avmm9898/Robot_final_Pj/doc/期末專題車體簡介 .pptx.pdf

# 機器人動力與控制 期末專題

# outline

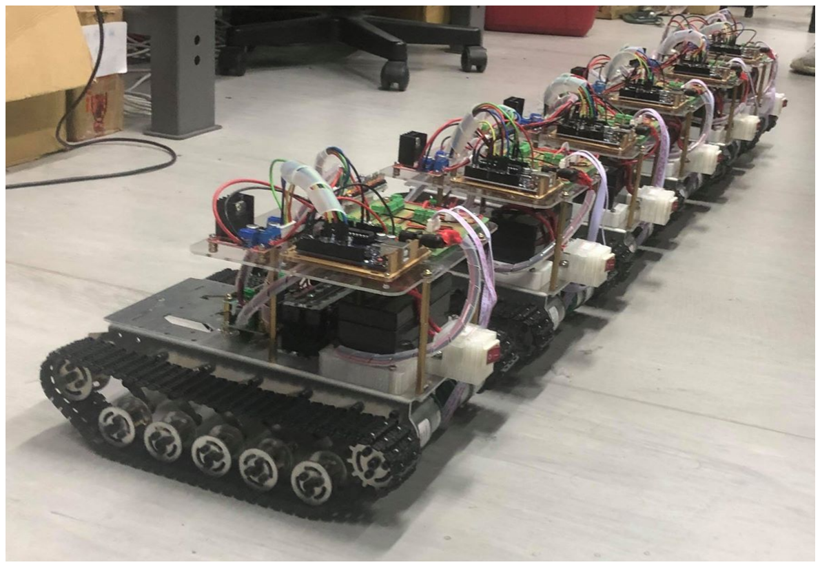
[picture p38: figure]

## 1. 期末專題任務介紹 2. 車體機構及硬體配置

### 3. 控制器 (arduino & pca9685) 4. 馬達驅動器 (h-bridge) 5. 馬達及Encoder

## 6. 線路圖及電路板 7. 機械手臂 8. 視覺辨識

### 9. arduino與pc的溝通 10. demo

## 11. 充電注意事項

# 期末專題任務介紹

在這次的專題中，我們的目標是讓履帶車前進，並控制車上的4R手臂，使其末端插入目標物的洞裡。

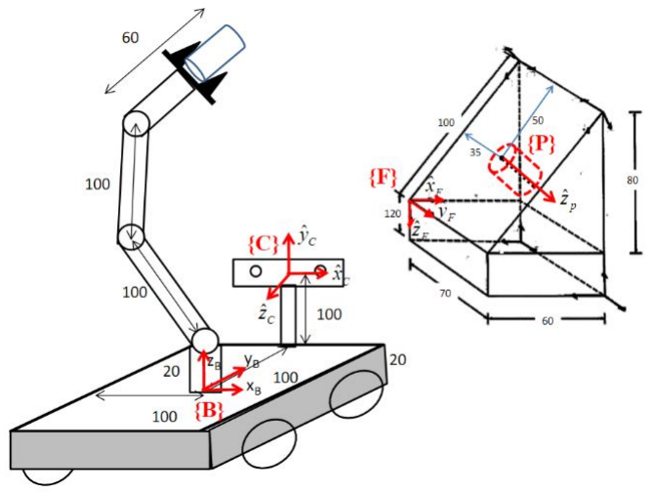
[picture p39: figure]

流程:
車體擺放在場地任一位置(可看到目標物)

車子移動到目標物旁

手臂移動使物件依序插入三個洞口(大中小)

# 車體機構及硬體配置

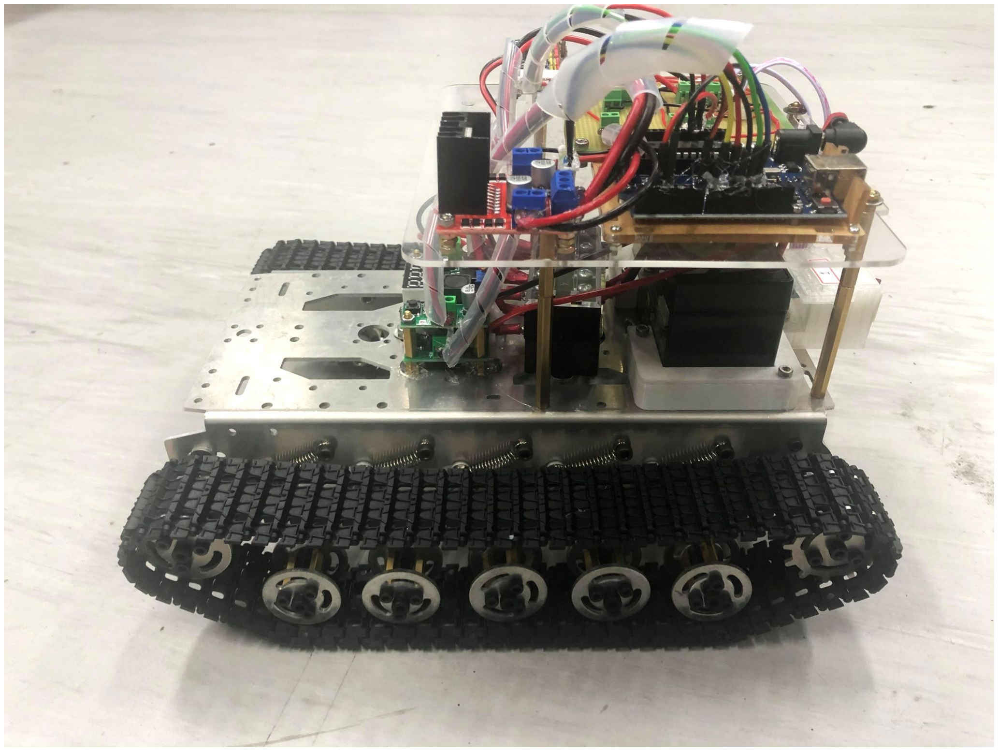
[picture p40: figure]

2nd floor:
Arduino、pca9685、H-bridge、電路板

1st floor:
開關、電池、端子台x2、降壓模組x2

# 分層介紹

# 控制器 (arduino & pca9685)

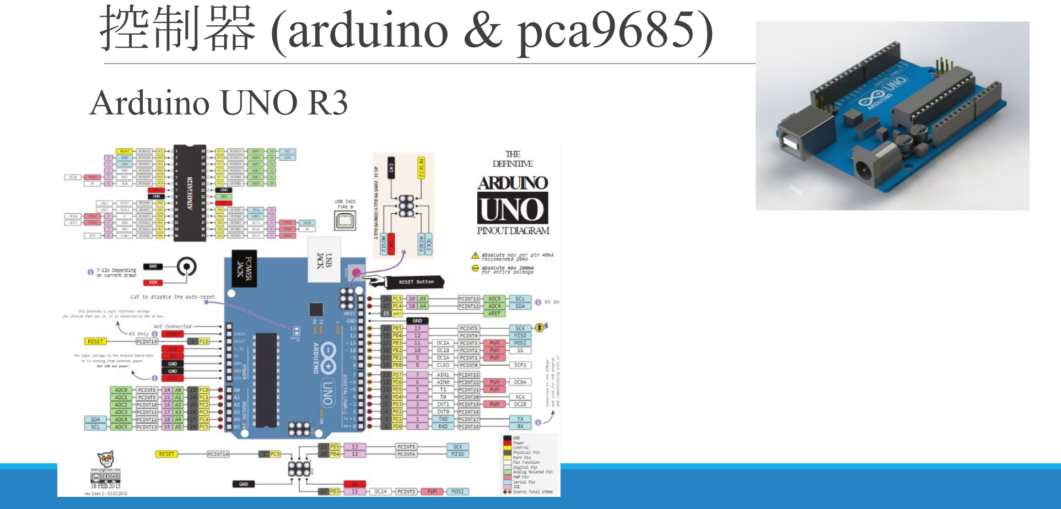
[picture p41: page 5]

## Arduino UNO R3

# Arduino 腳位分配

pin13 : h-bridge IN1 | pin6~ : 未使用
pin12: h-bridge IN2 | pin5~ : 未使用
pin11~ : h-bridge ENA | pin4 : 未使用

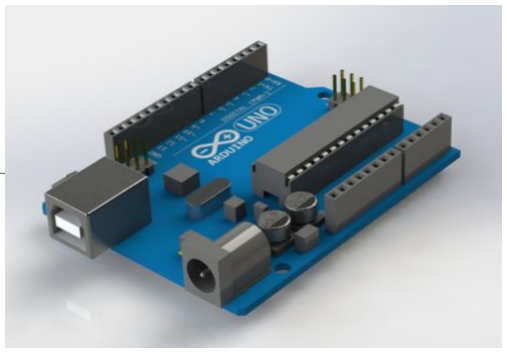
[picture p42: figure]

pin10~ : h-bridge ENB | pin3~ : 馬達B之encoder B相 | A4 : pca9685的SCA
pin9~ : 未使用 | pin2 : 馬達A之encoder B相 | A5 :pca9685的SCL

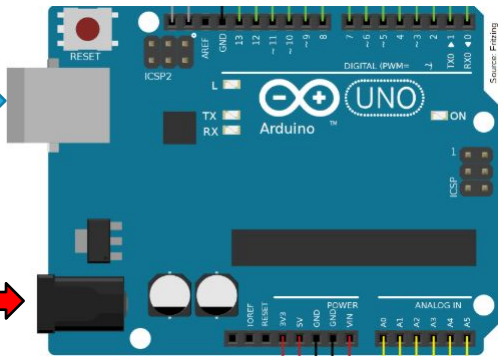
[picture p43: figure]

pin8 : h-bridge IN3

pin7 : h-bridge IN4

Vin (12V)

computer

# pca9685

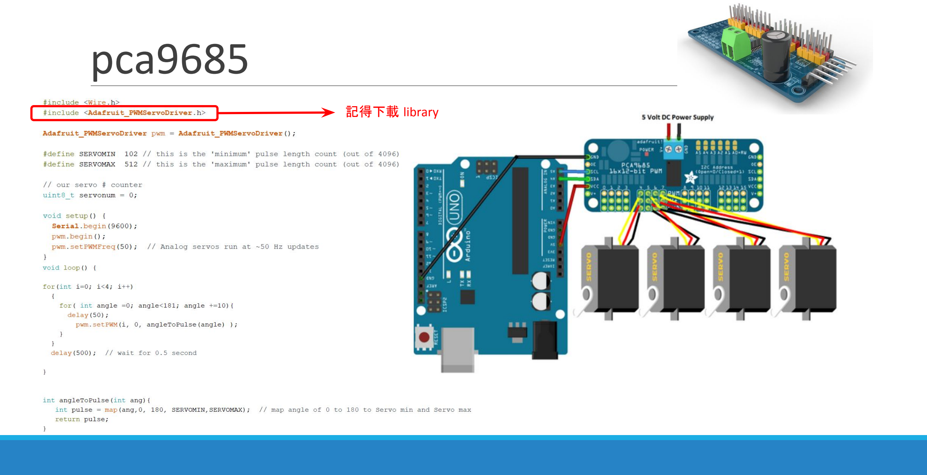
[picture p44: page 7]

記得下載 library

# 馬達驅動器 (H-bridge)

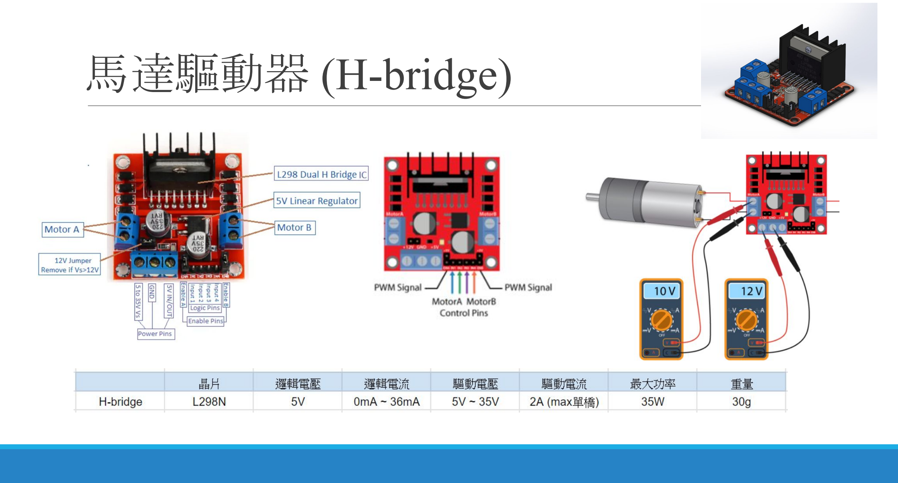
[picture p45: page 8]

# H-bridge 基礎控制 (直走)

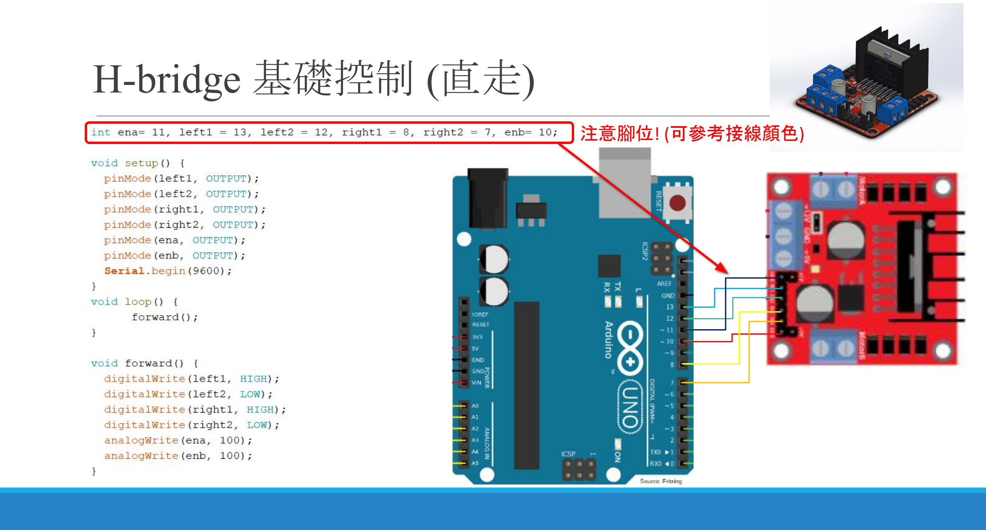
[picture p46: page 9]

注意腳位! (可參考接線顏色)

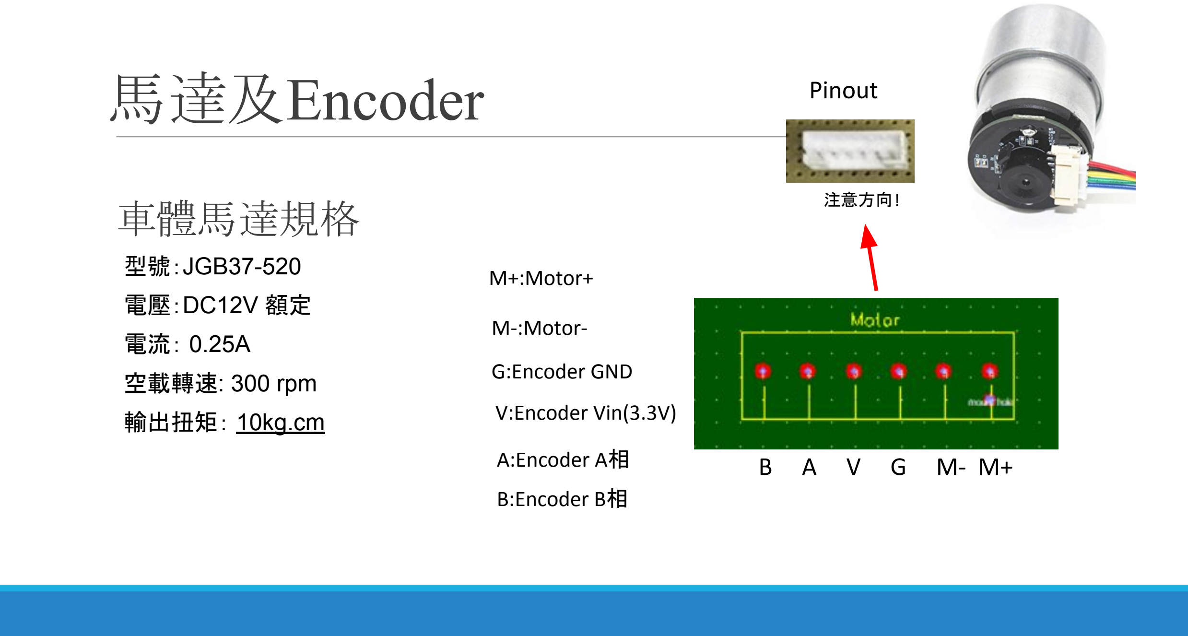
[picture p47: figure]
馬達及Encoder; 型號：JGB37-520; 空載轉速: 300 rpm; 輸出扭矩： 10kg.cm; M+:Motor+; M-:Motor-; G:Encoder GND; V:Encoder Vin(3.3V); A:Encoder A相; B:Encoder B相; 注意方向!; Pinout; 車體馬達規格

# Encoder

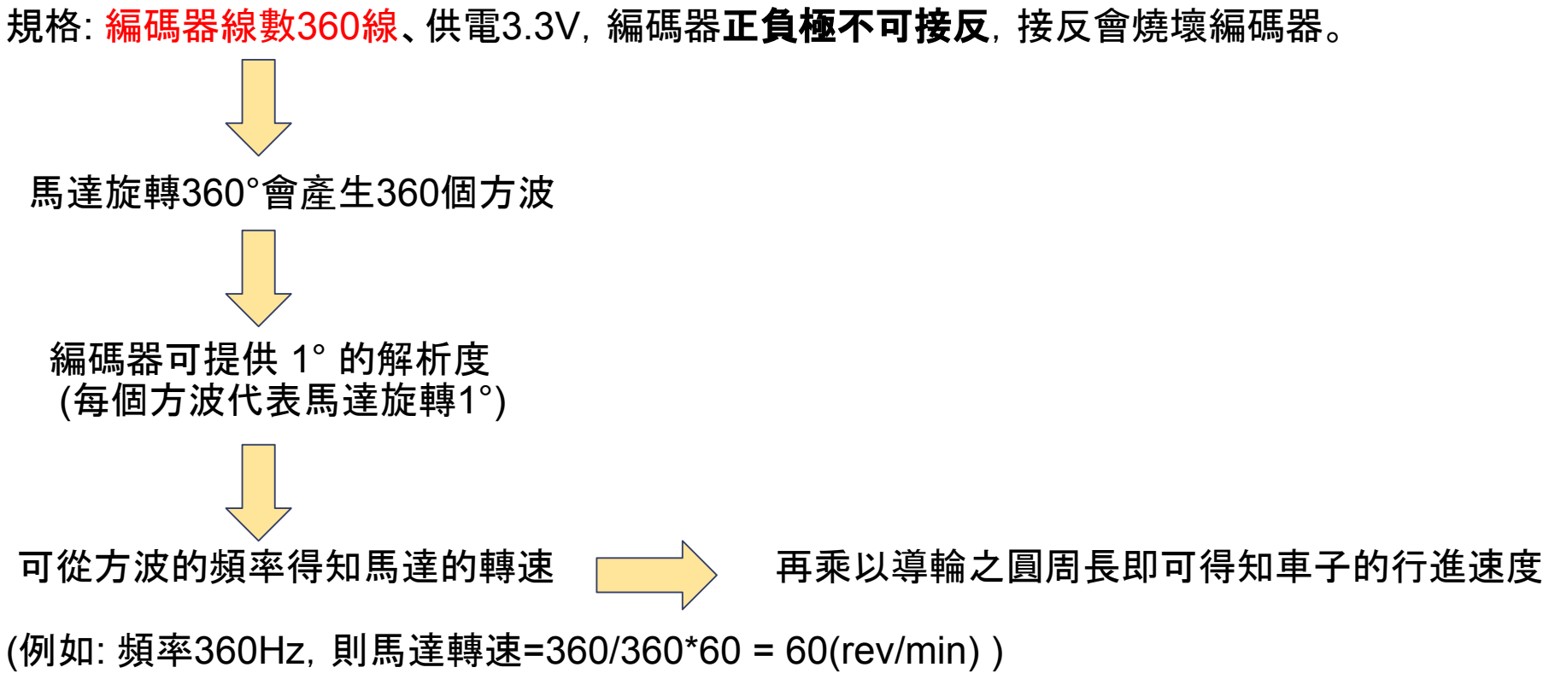
[picture p48: figure]
規格: 編碼器線數360線、供電3.3V，編碼器正負極不可接反，接反會燒壞編碼器。; 馬達旋轉360°會產生360個方波; 編碼器可提供 1° 的解析度; (每個方波代表馬達旋轉1°); 可從方波的頻率得知馬達的轉速; 再乘以導輪之圓周長即可得知車子的行進速度; (例如: 頻率360Hz，則馬達轉速=360/360*60 = 60(rev/min) )

# encoder AB相

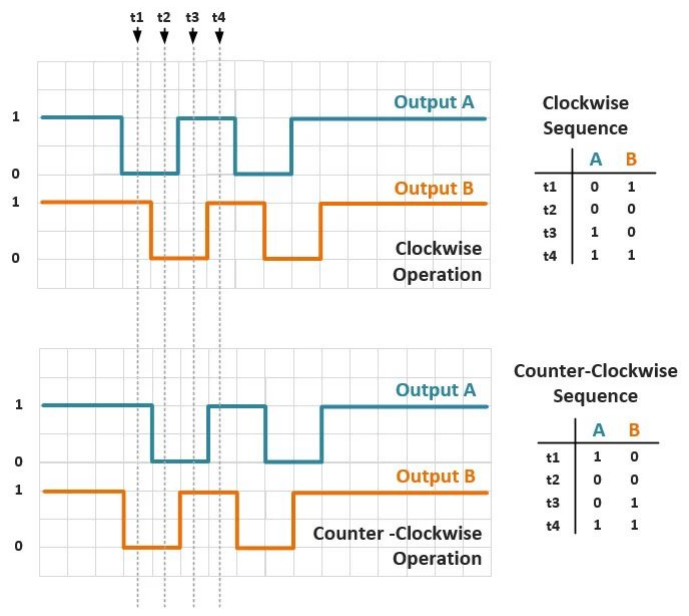
[picture p49: figure]

encoder 輸出的訊號分成A、B相，兩者之相位差為90°

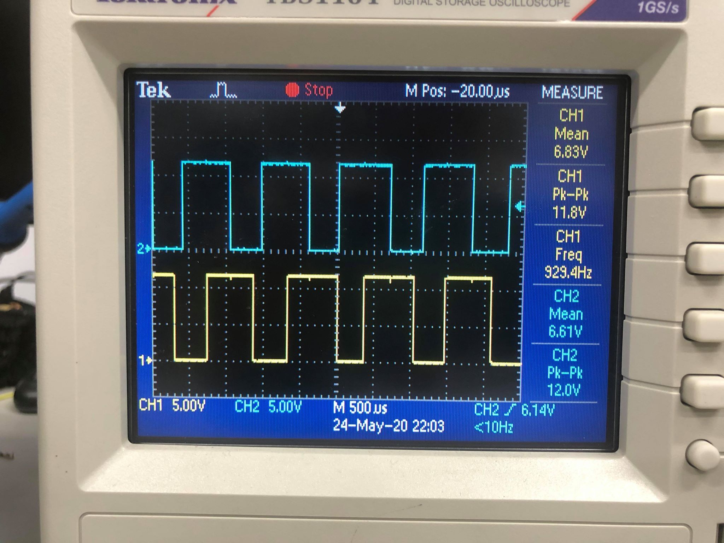
[picture p50: figure]

可從A、B相之先後關係得知馬達的轉向 | 實際測試訊號:

# encoder AB相

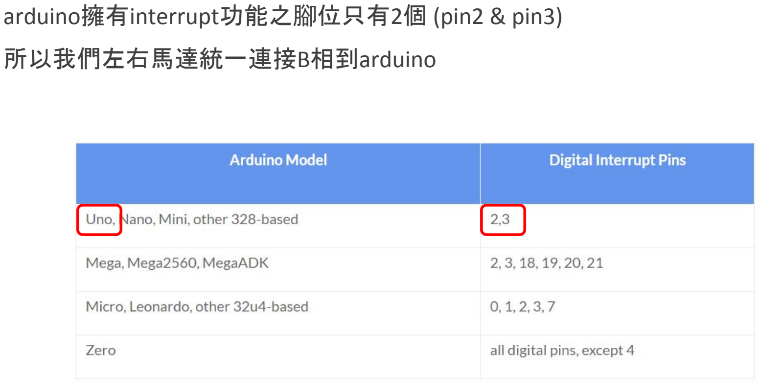
[picture p51: figure]
arduino擁有interrupt功能之腳位只有2個 (pin2 & pin3); 所以我們左右馬達統一連接B相到arduino

# encoder量測馬達轉速 範例程式

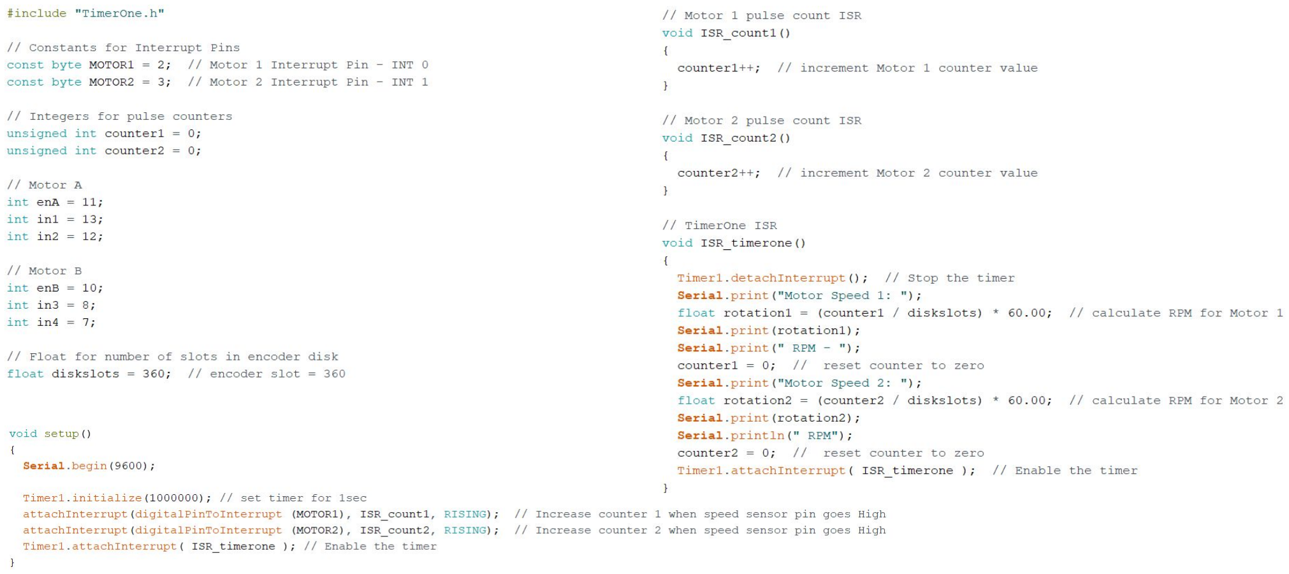
[picture p52: figure]

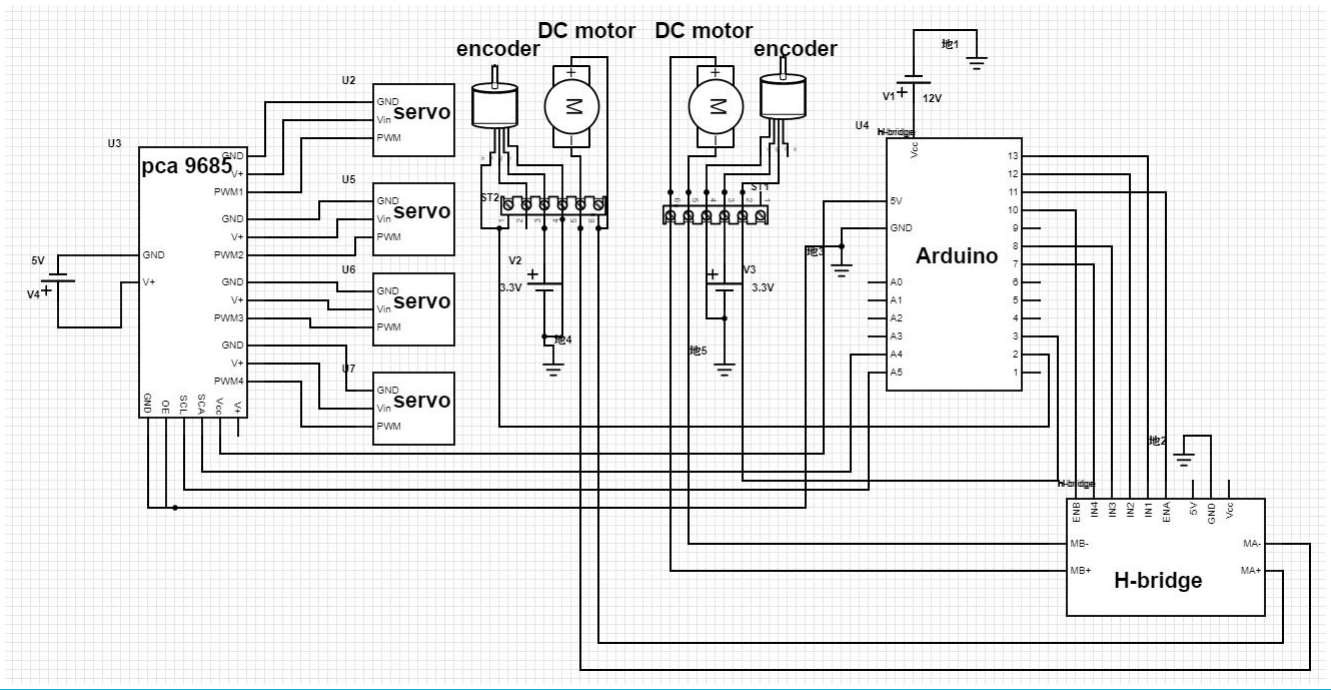
[picture p53: figure]

# 線路圖

# 線路圖及電路板

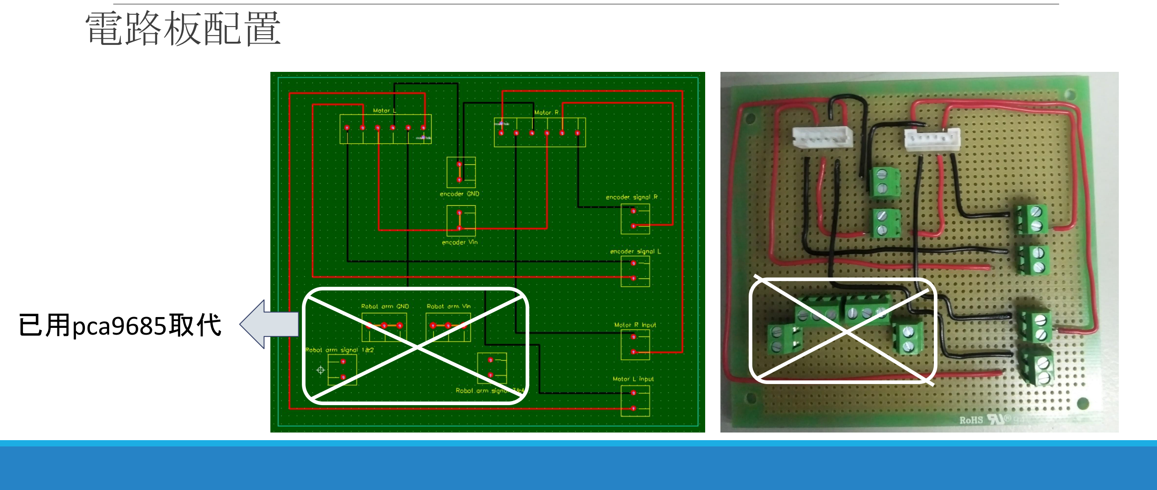
[picture p54: page 16]

# 電路板配置

### 已用pca9685取代

# 機械手臂

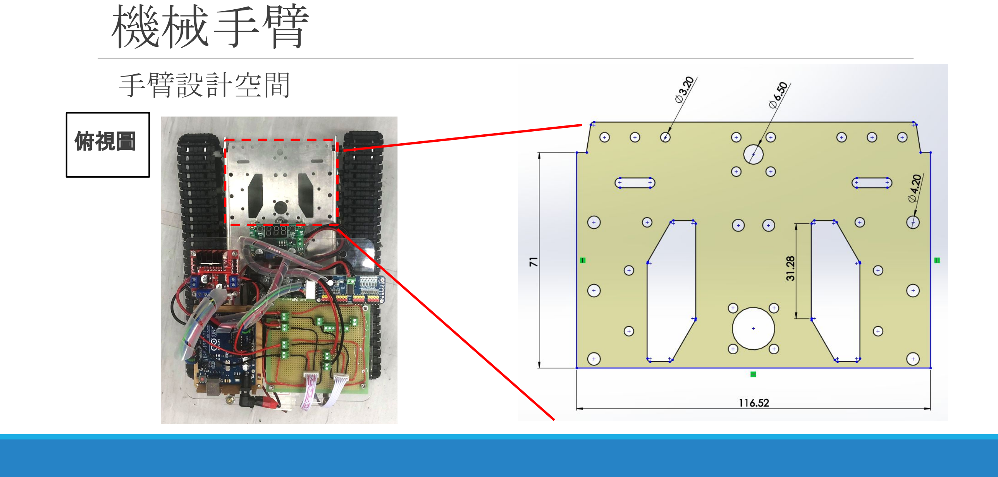
[picture p55: page 17]

俯視圖

## 手臂設計空間

# MG996R 規格

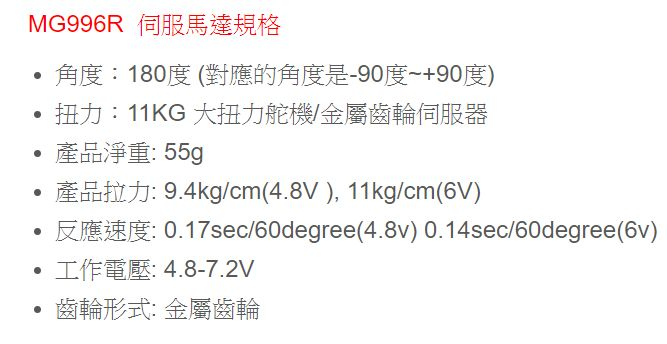
[picture p56: figure]

# MG996R solidworks

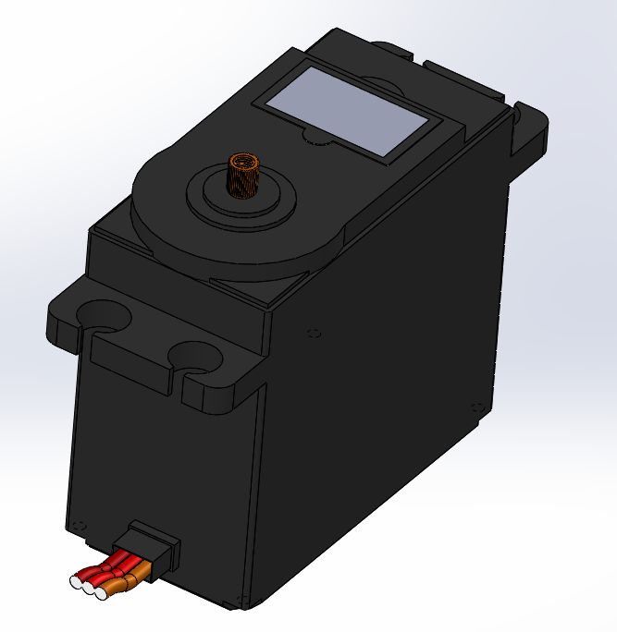
[picture p57: figure]
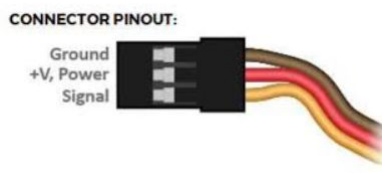
[picture p58: figure]

# 視覺辨識

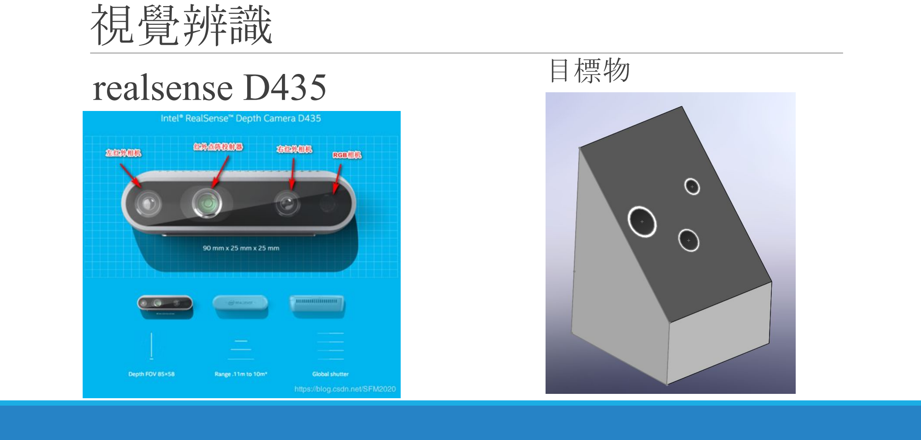
[picture p59: page 20]

realsense D435 | 目標物

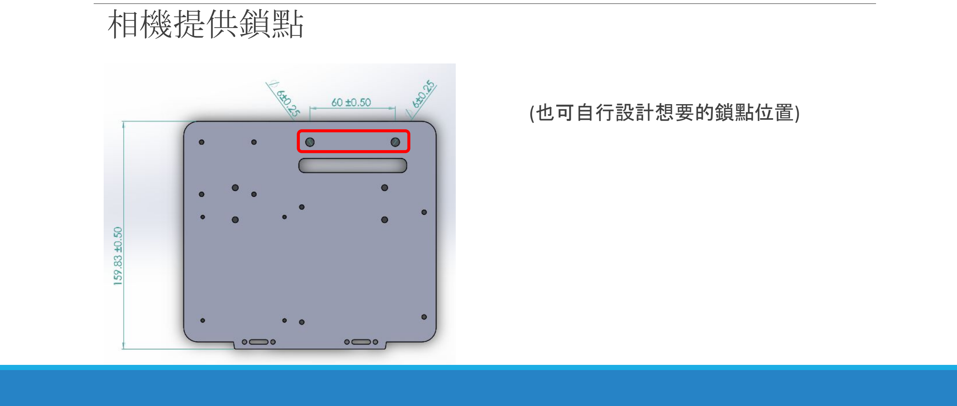
[picture p60: figure]
相機提供鎖點; (也可自行設計想要的鎖點位置)

# arduino與pc的溝通

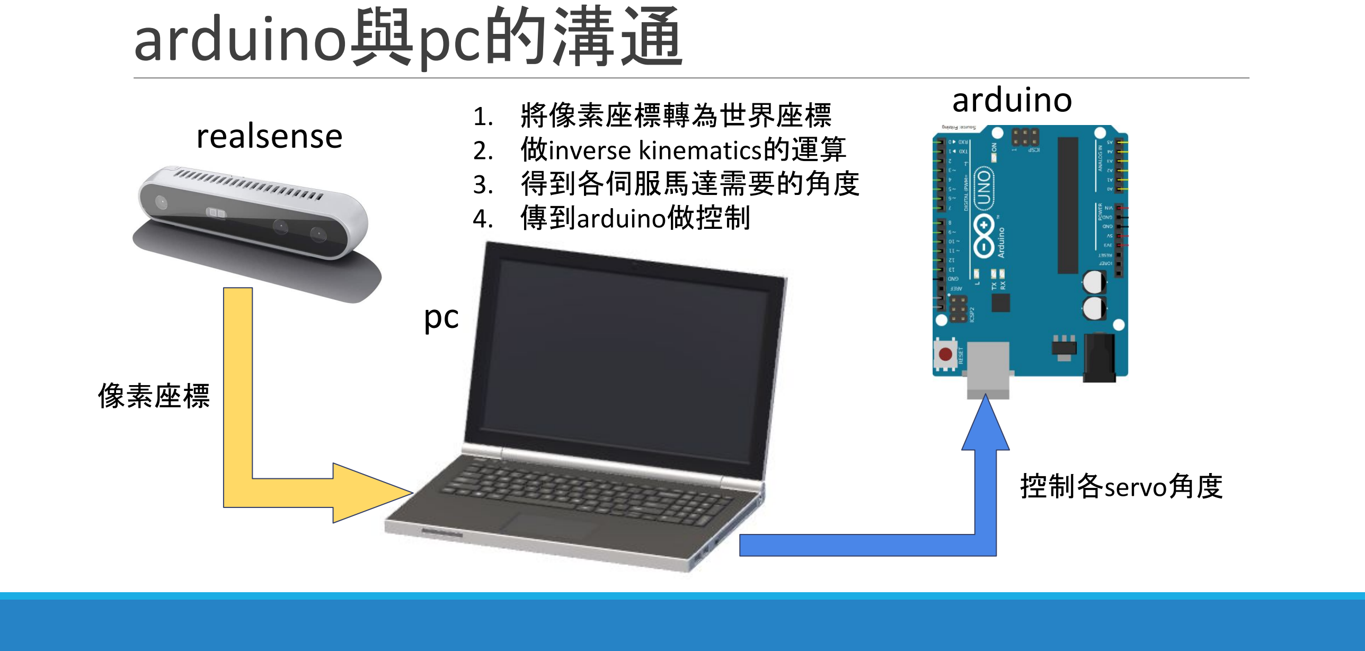
[picture p61: page 22]

## arduino

pc

realsense | 1. 將像素座標轉為世界座標
2. 做inverse kinematics的運算
3. 得到各伺服馬達需要的角度
4. 傳到arduino做控制

像素座標

控制各servo角度

# arduino與pc的溝通 範例程式

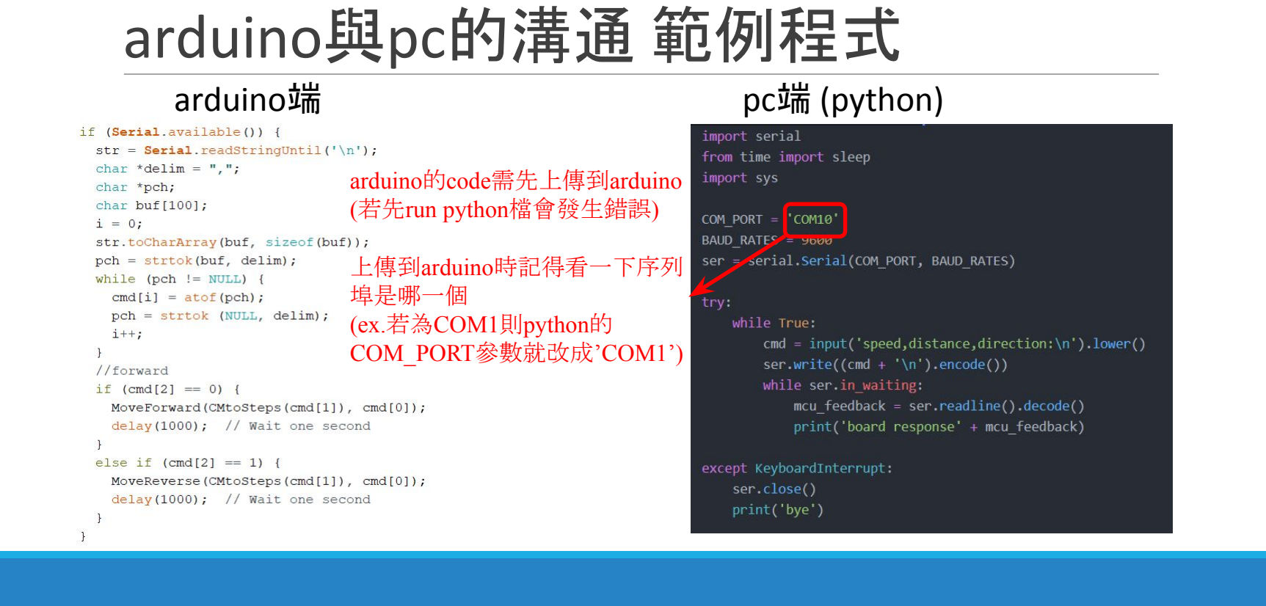
[picture p62: page 23]

arduino端 | pc端 (python)

arduino的code需先上傳到arduino
(若先run python檔會發生錯誤)

上傳到arduino時記得看一下序列
埠是哪一個
(ex.若為COM1則python的
COM_PORT參數就改成’COM1’)

# Demo

https://drive.google.com/file/d/1jVOSERYCBmgXQUd8nwmonmRnAgIjn4SV/view?usp=sharing (https://drive.google.com/file/d/1jVOSERYCBmgXQUd8nwmonmRnAgIjn4SV/view?usp=sharing)

# 充電注意事項

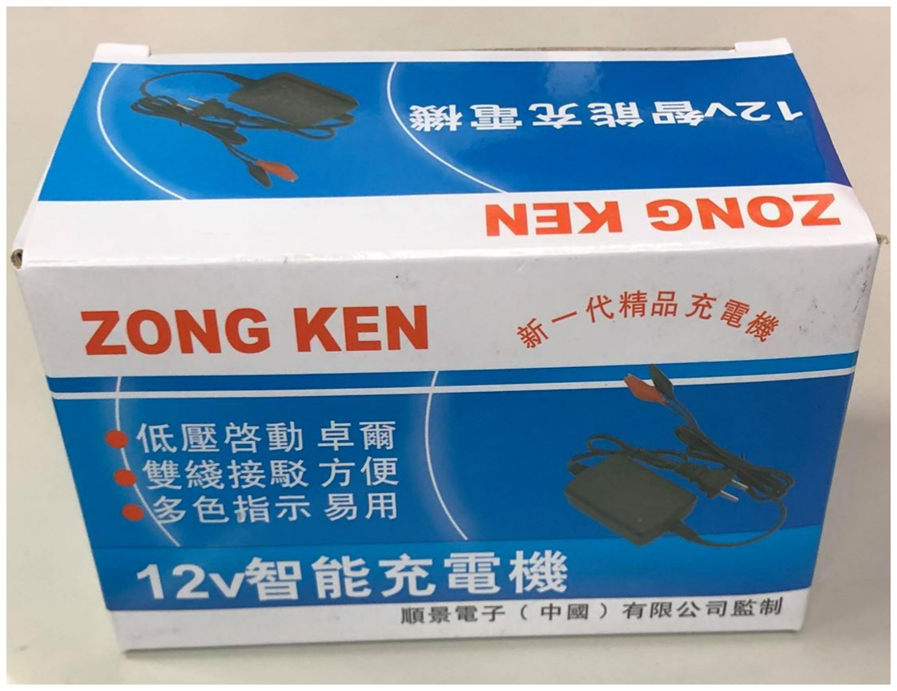
[picture p63: figure]

### 週五 (5/29) 之後在知武館原創 (200) 會放充電器

- 正接正 負接負
- 充電時把連接電池的線都拔掉
- 充電時會亮紅燈 充滿亮綠燈
- 大概半小時內就會充滿 (不要充太久 電池會壞)
