avmm9898/Robot_final_Pj/doc/431110_Real time circle detection using Realsense D435i.pptx

## Real time circle detection using Realsense D435i

2020/05/29
劉柏誼

## Outline

- 環境設置
- Realsense 使用方法
- 找圓與圓心演算法
- 座標系轉換

## 環境配置

- Anaconda 環境安裝
  - 安裝網址 : https (https://www.anaconda.com/)://www.anaconda.com/ (https://www.anaconda.com/)
  - OS : Windows、Linux、Mac
- Anaconda 介紹
  - Python數據科學平台
  - 套件管理
  - 虛擬環境管理

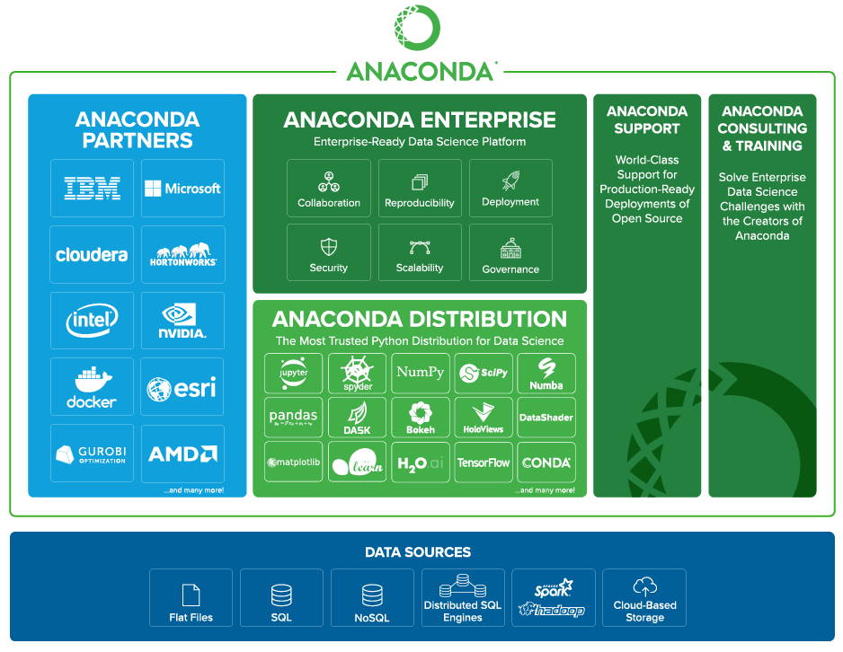
[picture p64: figure]

Ref: https://reurl.cc/d0OyMg

## 環境配置

- 使用搜尋開啟Anaconda Prompt
- 輸入’’conda create -n robot_final python==3.6’’ 創立名為’’robot_final’’的虛擬環境
  - (-n後名子可任設，python版本一個人喜好使用)
- 設置成功後畫面

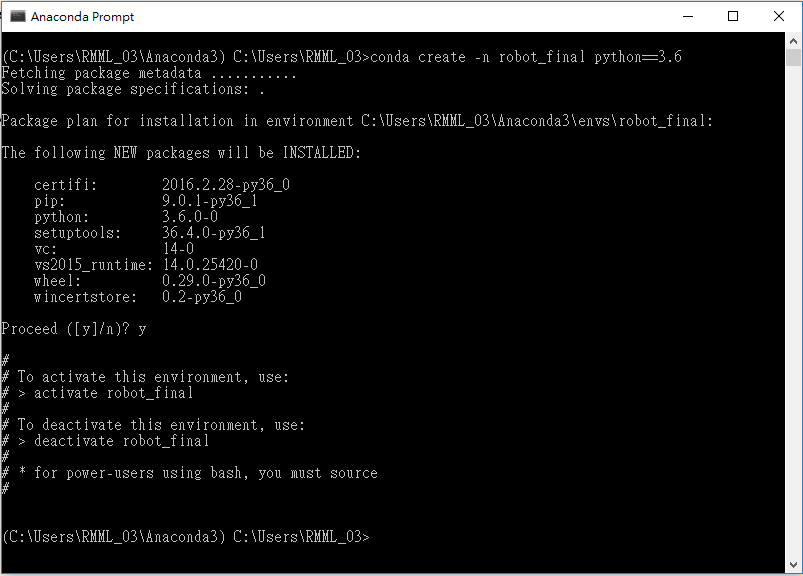
[picture p65: figure]

進入與退出虛擬空間指令

## 環境配置

- 啟用虛擬環境 : ‘’activate robot_final’’
- 安裝所需套件包 : ‘’conda/pip install packagename’’
  - 必要 : opencv(影像處理)、numpy(數據分析)、pyrealsense2(使用realsense)
  - 常用 : matplotlib(繪圖工具)、sympy(代數運算)、jupyter notebook(編譯器)
- 查看安裝好的套件 : ‘’conda list‘’

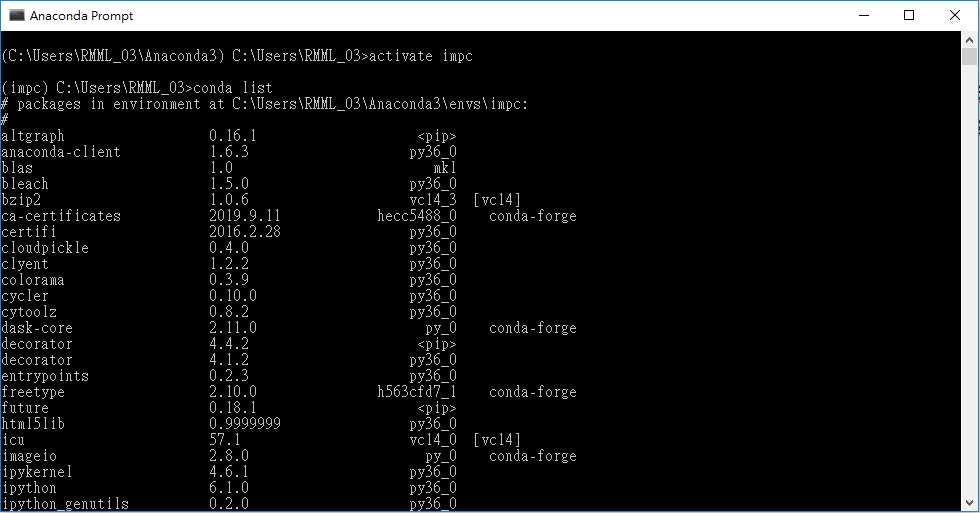
[picture p66: figure]

## Realsense使用方法 Realsense SDK

- 安裝網址 : https (https://www.intelrealsense.com/developers/)://www.intelrealsense.com/developers/ (https://www.intelrealsense.com/developers/)
- 下載安裝後會出現 Realsense viewer.exe
- 點開後可測試相機

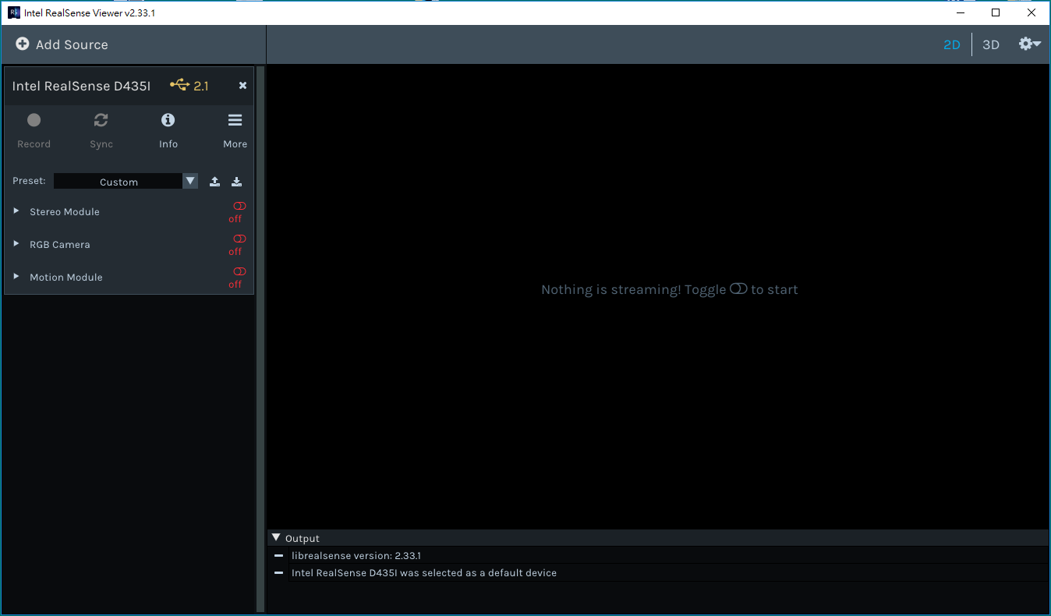
[picture p67: figure]

深度相機

彩色相機

## Realsense使用方法 使用python撰寫程式控制相機

- 程式架構

宣告使用套件

相機參數設定

## Realsense使用方法 使用python撰寫程式控制相機

啟動相機

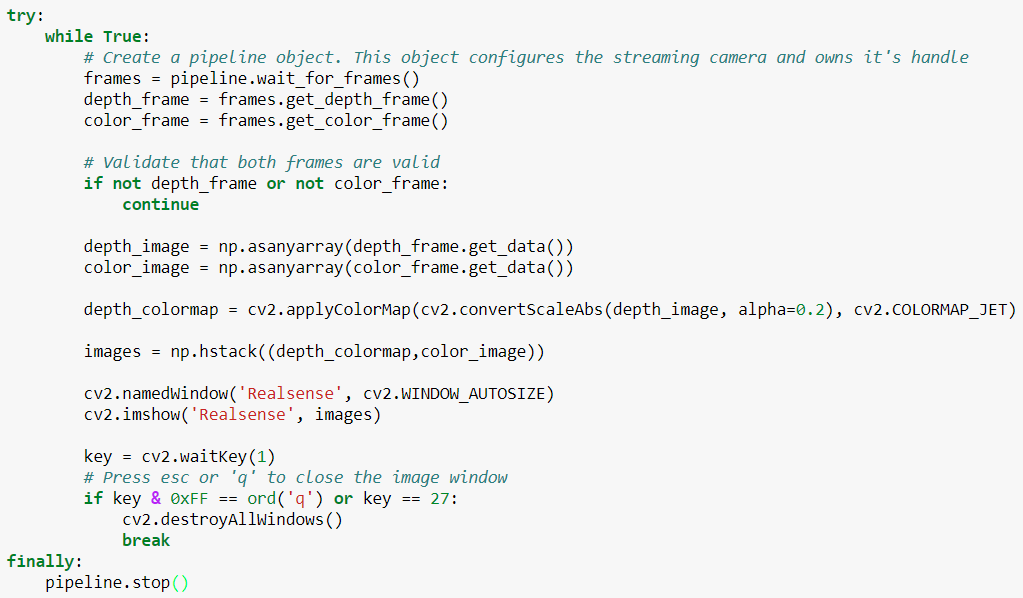
[picture p68: figure]

## 輸出結果

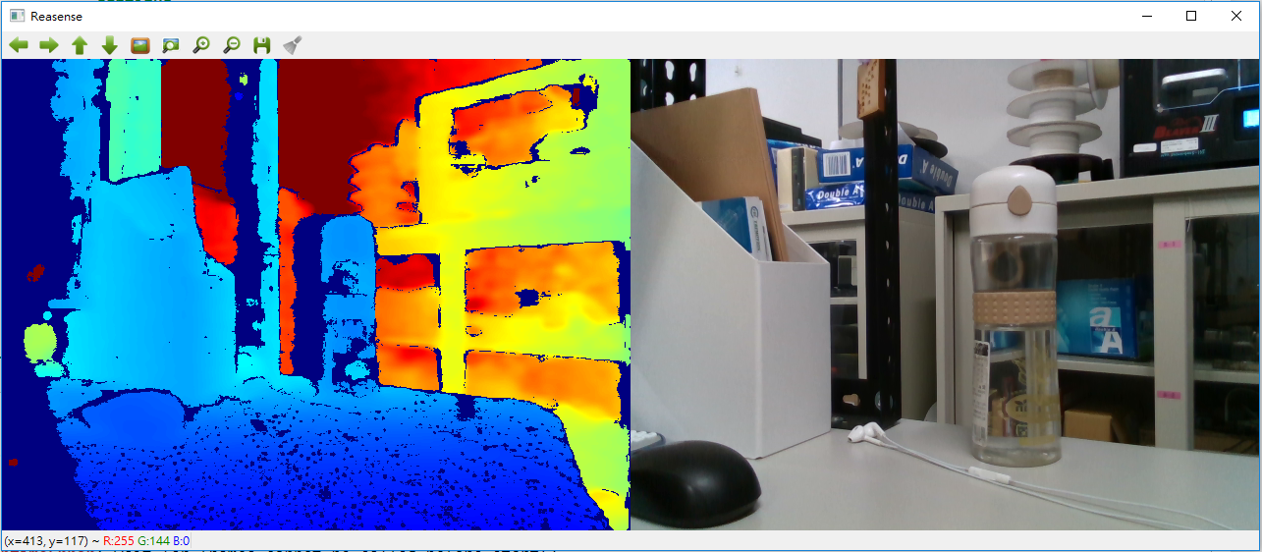
[picture p69: figure]

Depth

Color

Need to align depth image to color image !

## Realsense使用方法 使用python撰寫程式控制相機

Align 深度相機到RGB相機

新增程式碼

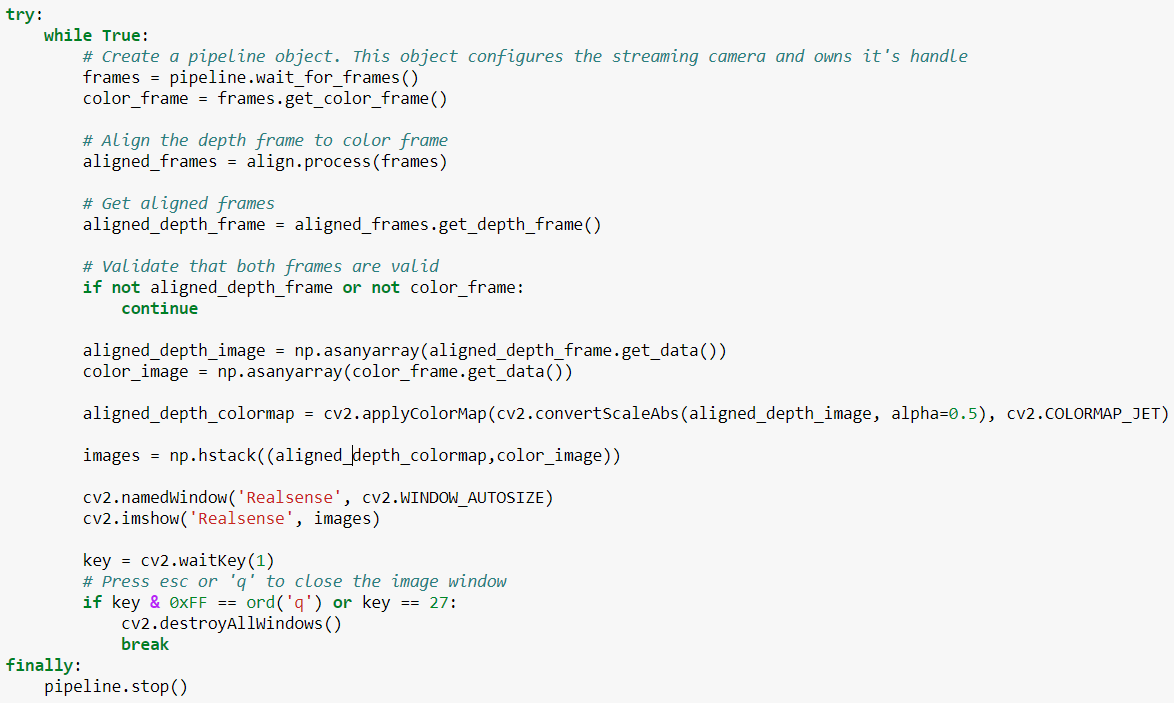
[picture p70: figure]

新增程式碼

## 輸出結果

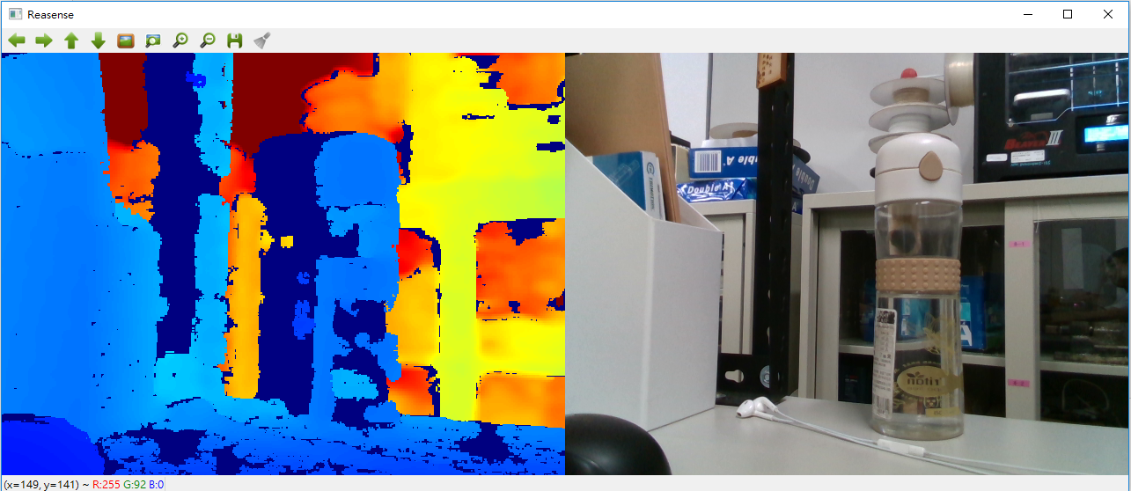
[picture p71: figure]

Aligned depth

Color

## 找圓與圓心演算法 流程圖

彩色影像

灰階影像

影像預處理

霍夫找圓演算法

Canny邊緣檢測

模糊處理

二值化處理

……

## 找圓與圓心演算法 程式碼

灰階影像

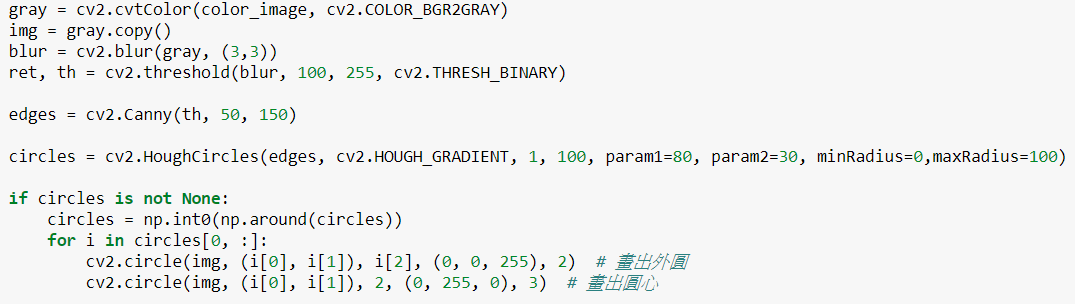
[picture p72: figure]

模糊處理

Canny邊緣檢測

二值化

霍夫找圓演算法

畫圓

(u, v, r) (unit : pixel)

u

圓心座標

圓半徑

v

image

## 輸出結果

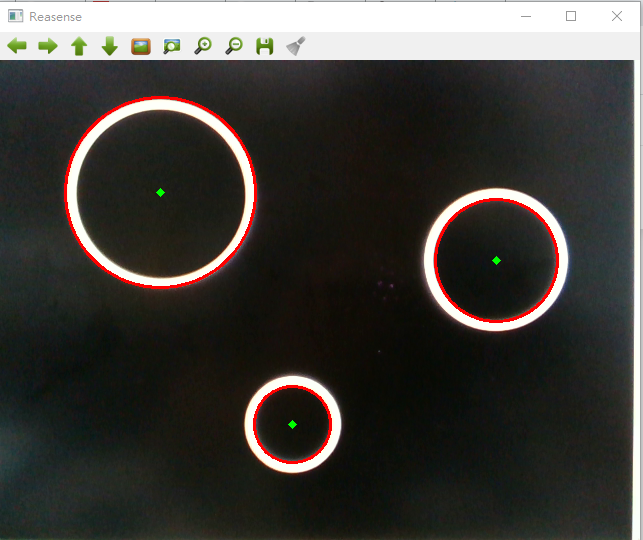
[picture p73: figure]
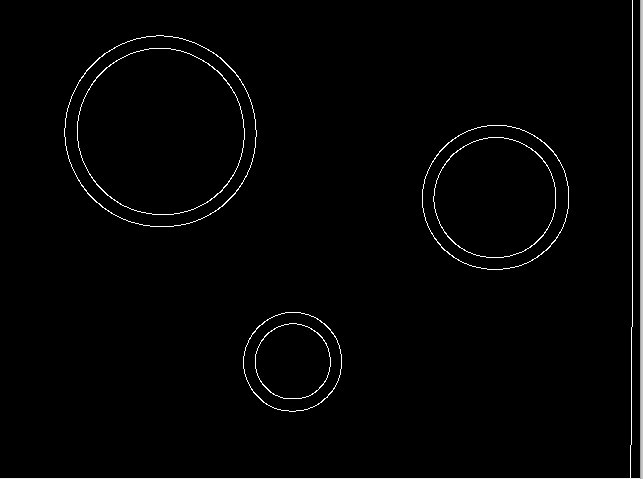
[picture p74: figure]

找圓並畫圓

Canny邊緣檢測

## 坐標系轉換

- 像素座標系
- 影像座標系
- 相機坐標系
- 世界座標系

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
[X_w Y_w Z_w 1]=[CWR, WP_(CORG) 0, 1][(Z_c dx)/f, 0, (−Z_c u_0 dx)/f0, (Z_c dy)/f, (−Z_c v_0 dy)/f0, 0 , Z_c 0, 0 , 1][uv1]

Xc

內部參數

Yc

Xw

Yw

外部參數
