avmm9898/Robot_final_Pj/(commit log)

2020-06-12 Create realsense_basic.py
    基本顯示圖像功能
2020-06-15 arduino example
2020-06-19 A bridge between arduino and python
2020-06-19 Add arm control example and speedup
2020-06-19 Integrate car and arm arduino code
2020-06-19 Add Document of sending command to arduino
2020-06-22 Add function of set and get wheel speed in Connector
2020-06-23 Update README.md
    上傳YOLO模型
2020-06-24 Use realsense to detect object and work with arduino(Unfinished)
2020-06-24 update playYOLO
    use detect_platfrom(frame)
    [platfrom.cfg]
2020-06-27 update weight
    [platform_tiny.cfg, yolov3_hole.cfg]
2020-06-27 arm function modified
2020-06-27 Modify arm inverse kinematic
2020-06-27 Move arm with visual
2020-06-29 Fix: Join the commit4fd18b13
    [arduino_connector.py, arduino_worker.ino, car_move_with_visual.py, playYOLO.py, realsense_basic.py, test_arm_repetitive.py]
2020-06-30 Update arm Dh and calibrate camera xyz
2020-06-30 Test arm precision
2020-06-30 Add moving arm code
2020-07-01 Update arm_inverse_kinematic.py
    attach some actual measurement about the T_AC
2020-07-02 Fix Camera
2020-07-02 Calibrate camera to realworld frame
2020-07-02 Update calibration
2020-07-02 arm yolo
2020-07-02 Refactor arm
2020-07-03 Add auto collection and update arm parameters
